zalotores/sistemaDeRiego/README.md

# sistemaDeRiego
# Proyecto mecatronico - UTN 
https://youtu.be/Zvare01FY24
