zalotores/sistemaDeRiego/informeProyectoTorres.pdf

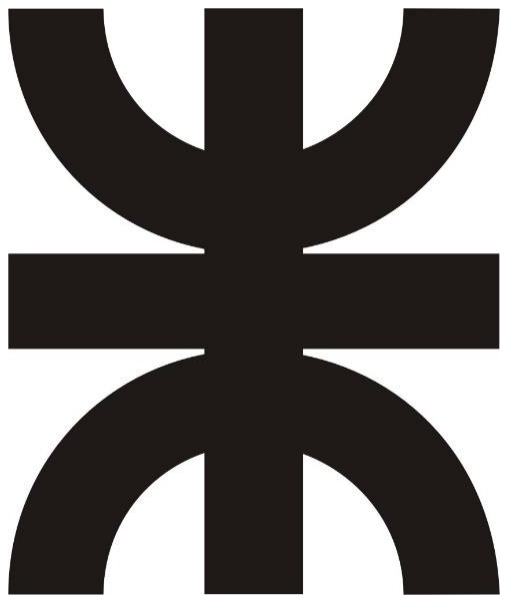
[picture p1: figure]

# UTN – FRC

# MECATRONICA 2

# PROYECTO MECATRONICO

# INFORME DE PROGRESO

## Torres, Horacio Gonzalo

108832

2020 - 2022 | Tecnicatura Superior en Mecatrónica
Docentes | Claudio Alejandro Zabala – Guillermo Stettler | Materia: | Mecatrónica II
Alumno: | Horacio Gonzalo Torres | Legajo: | 108832 | Curso: | 2M2

### INTRODUCCION

El presente informe tiene como objetivo ilustrar el proceso de desarrollo del sistema de riego automático que será presentado como proyecto final de esta tecnicatura; también incluye el manual de uso para el usuario final. Este proyecto tuvo inicio en el año 2020 con la intención de terminarlo dentro del ciclo lectivo de ese año; por variadas circunstancias se dejó de lado en la etapa de fabricación, completándose en diciembre de 2022.

2020 - 2022 | Tecnicatura Superior en Mecatrónica
Docentes | Claudio Alejandro Zabala – Guillermo Stettler | Materia: | Mecatrónica II
Alumno: | Horacio Gonzalo Torres | Legajo: | 108832 | Curso: | 2M2

### INDICE

Introducción | 1
Índice | 2

Anteproyecto
Elaboración | 3
Gantt | 3
Aprobación | 5

Investigación
Sensor de Humedad | 6
Reloj | 7
Actuadores | 8
Controlador | 8
Display i2c | 9
Reloj | 10
Reloj | 10
Botánica | 11

Programación
Lógica de Funcionamiento | 12
Desarrollo | 12
Código | 13
Materiales y Costos | 17
Construcción | 19
Conclusión | 25
Apéndice 1 – Manual de Usuario | 26

2020 - 2022 | Tecnicatura Superior en Mecatrónica
Docentes | Claudio Alejandro Zabala – Guillermo Stettler | Materia: | Mecatrónica II
Alumno: | Horacio Gonzalo Torres | Legajo: | 108832 | Curso: | 2M2

### ANTEPROYECTO

Elaboración:
Se pretende automatizar el riego de una quinta doméstica. Se utilizará un controlador con sensores de humedad y un reloj como entrada, y válvulas de caudal de agua como salida.
Se realizará con la idea de poder ampliar a un sistema de riego de frutales a futuro (como proyecto productivo); al utilizarlo en una quinta permite la construcción a escala real además de una maqueta, quedando la construcción en el sitio subordinada a otras obras de infraestructura.
La idea surgió originalmente como un proyecto de riego para una plantación de nogales en la provincia de San Luis. Los nogales necesitan una provisión de agua constante para lograr un crecimiento rápido y, de esta forma, poder entrar en producción. La plantación en cuestión pertenece a un tercero (amiga de la familia), por lo que la idea era, al tratarse de un proyecto de tecnicatura, que el propietario solo pague los materiales necesarios; el costo de mano de obra lo toma el alumno a cambio de la posibilidad de experimentar en el sitio, y la experiencia obtenida.
La actual pandemia limito severamente la posibilidad de viajar y planificar acciones a distancia en el mediano y corto plazo. Esta misma pandemia también propicio la creación de una quinta doméstica en nuestro hogar, por lo que una solución para poder realizar el proyecto en los plazos estipulados por la catedra, y al mismo tiempo beneficiar la economía y alimentación familiar se presentó en la forma de un cambio de objetivos, manteniendo el núcleo del proyecto con mínimas modificaciones.
Otra de las razones que impulsan este proyecto es la construcción de una nueva casa en la zona de Anisacate; en este terreno ya estaba planificada una quinta, y un sistema de riego automático sería un agregado de valor al proyecto familiar.
Como objetivo general, se busca lograr un sistema de riego autónomo y eficiente. Como objetivos individuales pueden mencionarse familiarizarse con sensores, clock y actuadores, aprender y manejar lenguajes de programación para controladores, manejar conexiones AC/DC, fabricación de una fuente CC, mejorar la manufactura de plaquetas y técnicas de soldadura, cálculo de resistencia estructural, investigar ciclos de crecimiento y humedad necesarias para diversos tipos de plantas.
El proyecto fue escogido, entre otros factores, por la factibilidad y economía relativa para llevarlo a cabo. La idea es lograr terminar el mismo en los plazos estipulados y hacerlo con cierta flexibilidad, lo que permitirá la implementación en diversos grados de complejidad.
Si bien hay otros proyectos de mayor complejidad que pueden desarrollarse en tiempos similares, este sistema tiene integración con varias de las materias de la tecnicatura (mecánica, electrónica, mecatrónica, materiales, física, calidad) por lo que considero que es adecuado como proyecto mecatrónico.
Este tema aborda un problema de índole domiciliario, y también se puede llevar a una escala mayor, por lo que se podría extender a una solución industrial. Si bien no se hizo todavía un análisis de costos, en general se considera factible ya que todos los componentes son de costo bajo/ moderado, y los conocimientos para realizar el proyecto se adquirieron en la carrera, salvando cuestiones particulares que se deberán investigar para aplicar eficientemente el mismo.

Diagrama de Gantt:

Se incluye, a modo ilustrativo, el diagrama original para el anteproyecto. El mismo se ira modificando a medida que avance el proyecto para mantenerse acorde al progreso actual, tratando dentro de lo posible de mantener las fechas de entrega dentro de lo programado con el objetivo de completar el proyecto en este mismo año. Cabe destacar que se producirán retrasos tanto por logística de materiales como por la formación académica necesaria para concretar las diferentes etapas del proyecto, ya que la fecha indicada en el diagrama no tiene en cuenta la curva de aprendizaje y nivel técnico necesario para construir las diferentes partes.

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

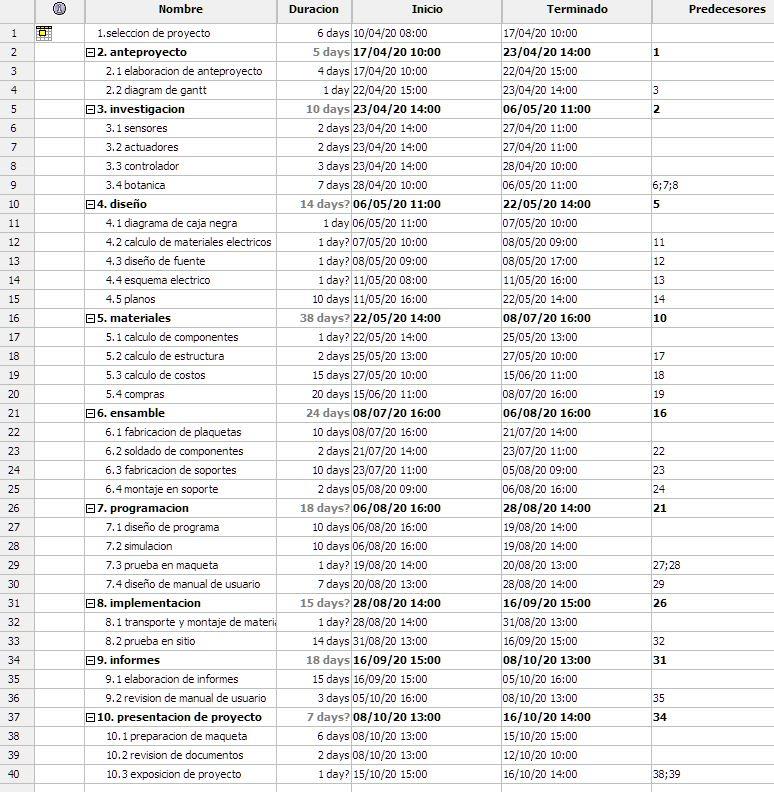
[picture p2: figure]

Figura 1

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

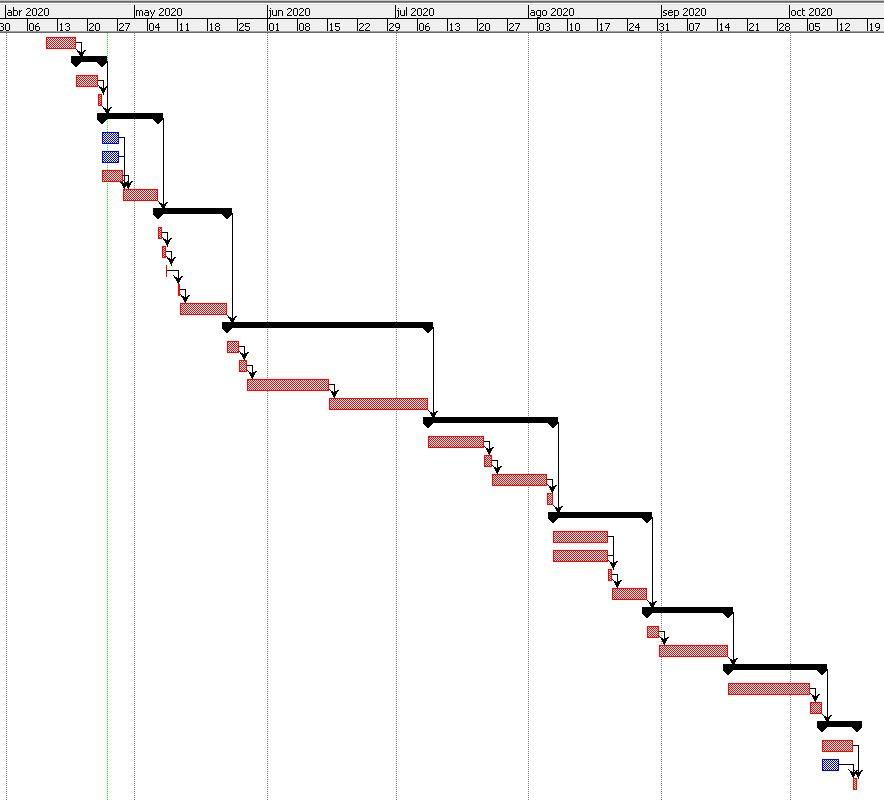
[picture p3: figure]

Figura 2

Aprobación:

El presente proyecto fue enviado para aprobación el día 23 de Abril del año 2020, y aprobado para su construcción el día 28 de Abril del mismo año.

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

### INVESTIGACION

Sensor de Humedad:

El sistema de riego funciona en base a sensores y actuadores, los cuales se tomarán como dispositivos de entrada y salida, respectivamente; un controlador tomara los datos de entrada y actuara, basando en instrucciones preestablecidas, sobre los actuadores para generar las condiciones de humedad requeridas según el tipo de cultivo que se tenga en consideración.
Para la realización del proyecto se utilizarán dos tipos de sensores o dispositivos de entrada. Estos serán un sensor de humedad y un reloj que, si bien no es un sensor, es un elemento necesario para medir escalas de tiempo prolongadas (del orden de días).

El sensor de humedad elegido es el FC-28, el mismo tiene un costo relativamente bajo y una vida útil de varios años.

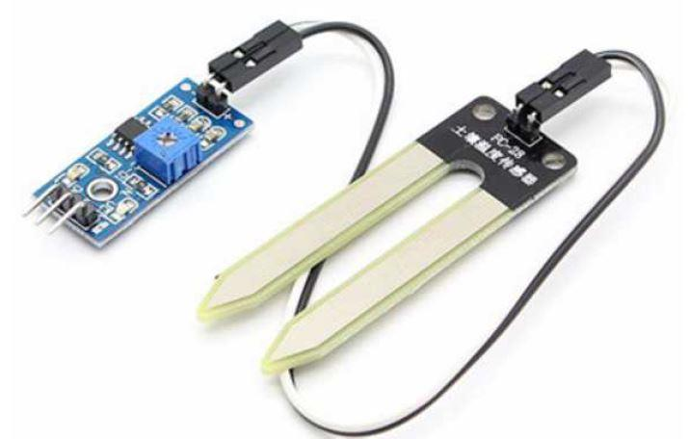
[picture p4: figure]

Figura 3

Un higrómetro de suelo FC-28 es un sensor que mide la humedad del suelo. Son ampliamente empleados en sistemas automáticos de riego para detectar cuando es necesario activar el sistema de bombeo. El FC-28 es un sensor sencillo que mide la humedad del suelo por la variación de su conductividad. No tiene la precisión suficiente para realizar una medición absoluta de la humedad del suelo, pero tampoco es necesario para controlar un sistema de riego. El FC-28 se distribuye con una placa de medición estándar que permite obtener la medición como valor analógico o como una salida digital, activada cuando la humedad supera un cierto umbral. Los valores obtenidos van desde 0 sumergido en agua, a 1023 en el aire (o en un suelo muy seco). Un suelo ligeramente húmero daría valores típicos de 600-700, mientras que un suelo seco tendrá valores de 800-1023.
Se pretende usar esta variación analógica para adaptar el sistema a diferentes condiciones de humedad, las que son necesarias teniendo en cuenta la variedad de vegetales que se encuentran en un quinta. De esta forma, se pueden separar los distintos tipos de suelo utilizando un sensor por zona, y ajustando el valor que el controlador tomara como umbral para activar el riego.
El esquema de montaje se muestra en la fig. 4. Al tratarse de una entrada analógica, solo pueden usarse los pines analógicos del micro; en caso de necesitar un número elevado de sensores, se pueden usar en modo digital, configurando un valor umbral para cada sensor, el cual enviara una señal digital al micro para indicar la activación o cierre de riego. También se utiliza como sensor de nivel en modo digital para asegurar el suministro de agua de riego.

2020 - 2022 | Tecnicatura Superior en Mecatrónica

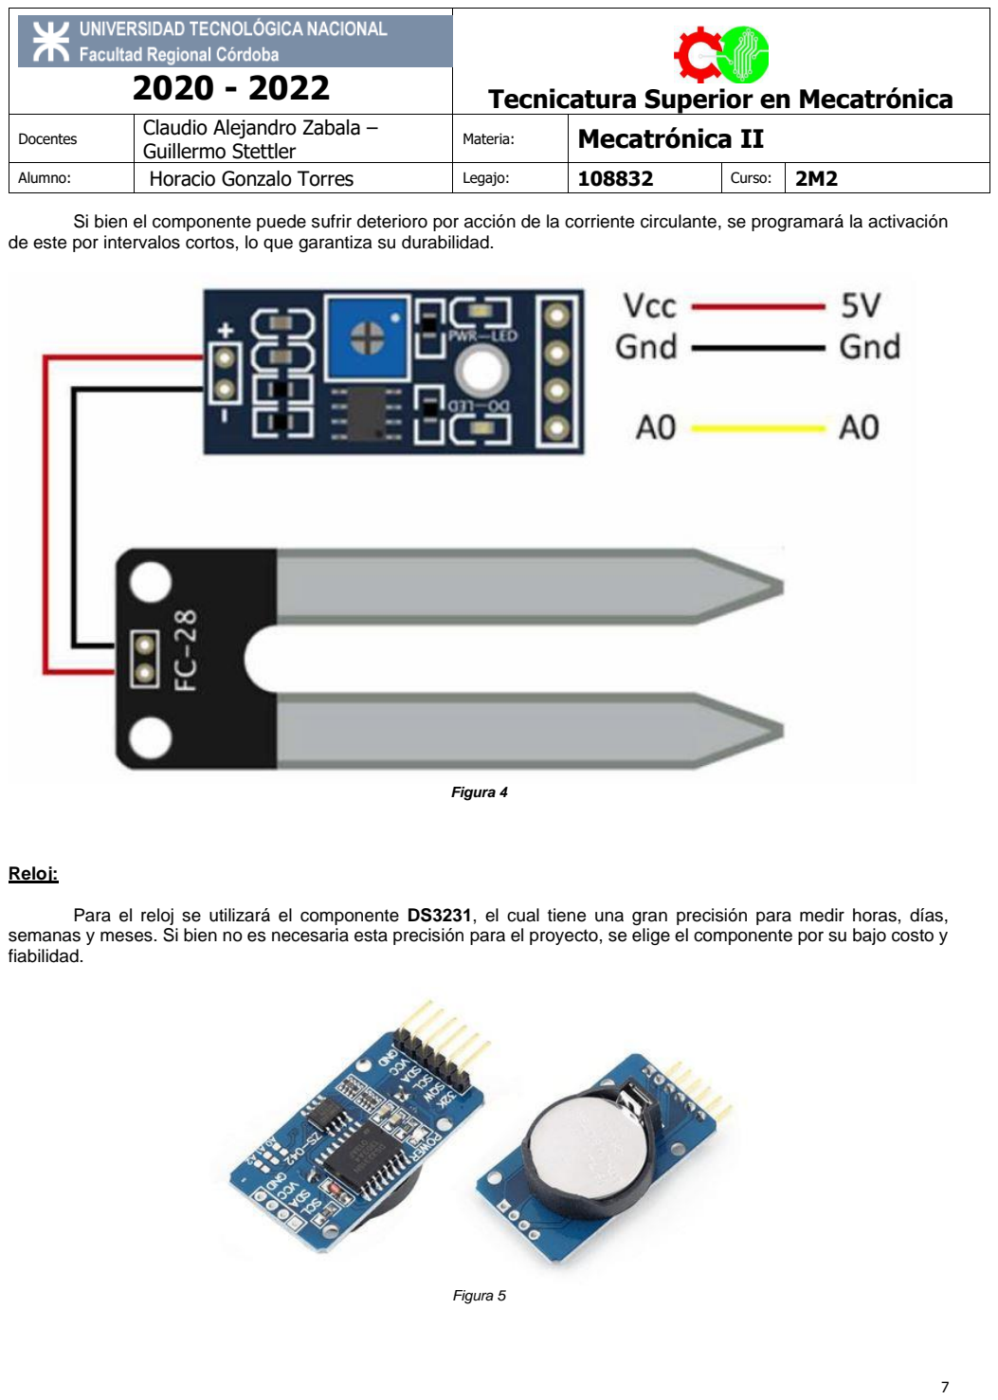
[picture p5: page 8]
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

Si bien el componente puede sufrir deterioro por acción de la corriente circulante, se programará la activación de este por intervalos cortos, lo que garantiza su durabilidad.

Figura 4

Reloj:

Para el reloj se utilizará el componente DS3231, el cual tiene una gran precisión para medir horas, días, semanas y meses. Si bien no es necesaria esta precisión para el proyecto, se elige el componente por su bajo costo y fiabilidad.

Figura 5

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

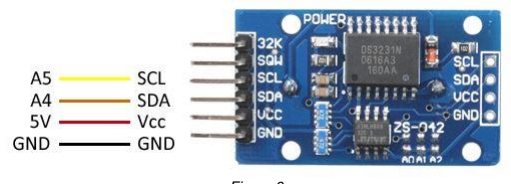
[picture p6: figure]

Figura 6

La medición de tiempo es necesaria, ya que hay plantas que requieren desde un riego diario a un riego semanal; también cambian los requerimientos de riego en la época de cosecha. Este componente también cuenta con un sensor de temperatura, el que puede ser útil para llevar un registro de la temperatura ambiente. Al contar con una fuente de alimentación propia, se puede usar como controlador de encendido de todo el sistema, reduciendo el consumo eléctrico y reduciendo el impacto de posibles cortes de energía desde la red.

Actuadores:

Para controlar el flujo de agua, se utilizan bombas de agua sumergibles para pecera, las cuales funcionan con una alimentación de 5V, tienen un costo bajo y una vida útil aceptable.

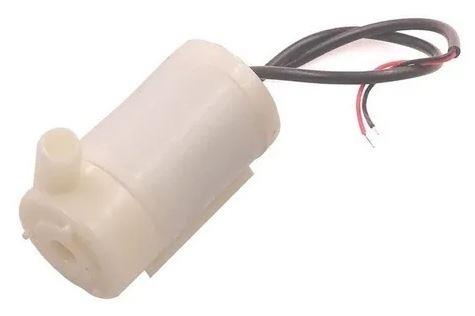
[picture p7: figure]

Figura 7

La conexión es muy sencilla, pudiéndose controlar con señales digitales. Dependiendo del tipo de aspersor se puede utilizar tanto para riego de superficie (como es el caso del tomate) como para riego tipo lluvia (como es el caso de la lechuga). Si bien también se podrían utilizar para llenar el depósito de agua, es preferible en este proyecto un sistema de llenado mecánico por flotante, al tener disponibilidad de agua corriente; para zonas donde no haya disponibilidad es recomendable una bomba de mayor caudal, el que se logra aumentando la potencia (y consecuentemente el costo) de la misma.

Controlador:

El controlador por utilizar es el ATmega328P, el cual se programa en una placa Arduino Uno, y posteriormente se monta en una placa de desarrollo propia. El mismo se alimenta de una fuente regulada a 5 Vcc, la cual también alimenta a las bombas de riego.

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

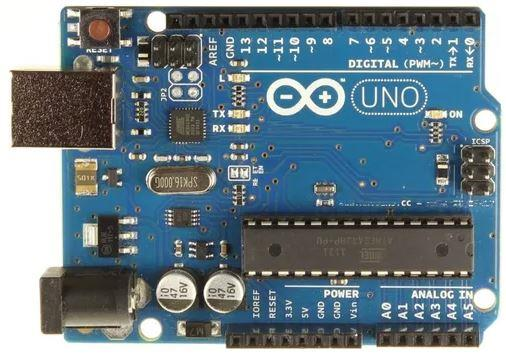
[picture p8: figure]

Figura 8

Este controlador dispone de seis entradas analógicas y trece digitales. El reloj utiliza dos entradas analógicas, por lo que admite hasta cuatro sensores (o zonas) de humedad en medición directa, pudiéndose agregar otros cuatro sensores adicionales en medición digital. Para aumentar la cantidad de señores (o zonas) sería necesario agregar un segundo micro, pero esto no es necesario para el caso de una quinta doméstica. También se pueden agregar interruptores para activar el modo de riego alternativo en situación de cosecha, los cuales se computan como entradas digitales.

Display i²c:

Para mostrar la información de salida se utiliza un display i2c, lo que permite simplificar el cableado no solo de la pantalla, sino también de los demás componentes que se conecten al microcontrolador. El protocolo de comunicación es ideal para este proyecto, ya que las distancias de conexión son pequeñas, y el menor cableado permite un producto final más compacto. El display en cuestión es de 16 caracteres con dos líneas de salida.

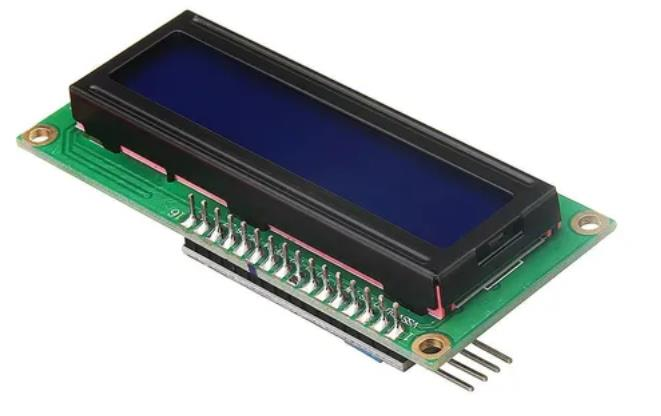
[picture p9: figure]

Figura 9

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

Potenciómetros:

Para regular los niveles de humedad se utilizan potenciómetros lineales de 10k conectados a las entradas analógicas del controlador, esto garantiza un movimiento lineal y continuo entre los valores de entrada.

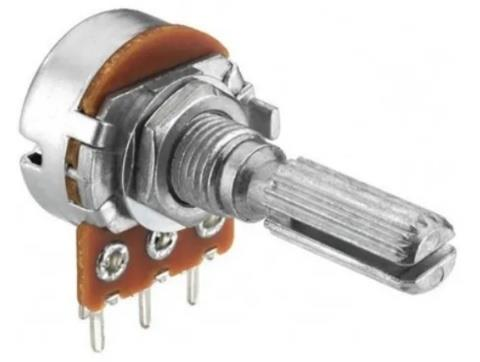
[picture p10: figure]

Figura 10

Salida de Potencia:

Para la salida de los actuadores se utiliza un puente H en una placa L298N, de esta forma se evita drenar demasiada potencia del controlador, lo que puede resultar en un daño de este.

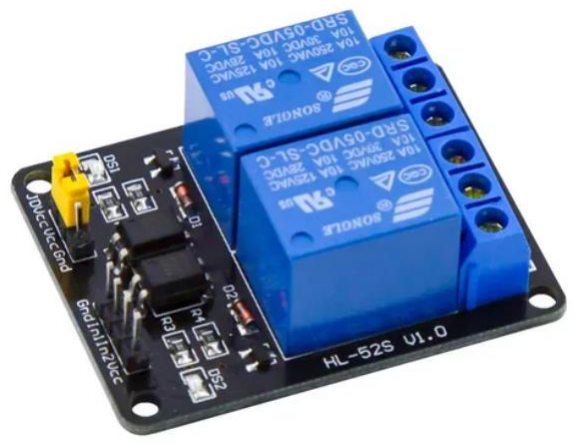
[picture p11: figure]

Figura 11

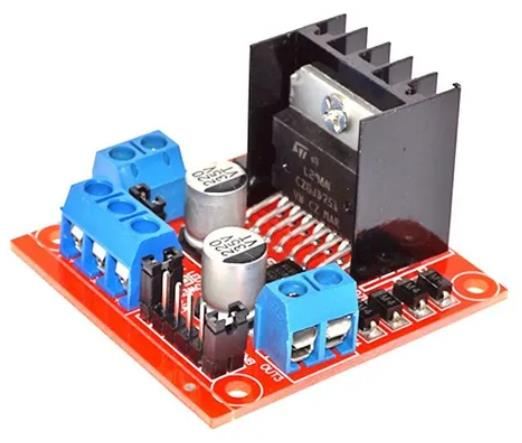
[picture p12: figure]

En caso de que se necesite escalar el proyecto, se puede reemplazar el puente por una placa de Relays, lo que permite cambiar las bombas de 5V por bombas de 220V, o también por válvulas de 220V dependiendo de la fuente de agua disponible.

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

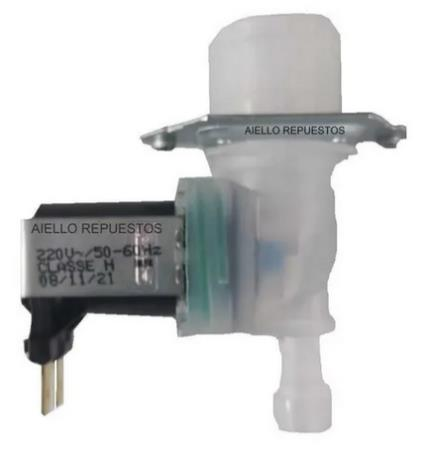
[picture p13: figure]

Figura 12

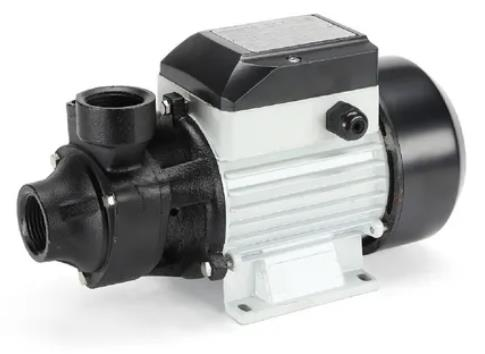
[picture p14: figure]

Botánica:

Se pueden tomar dos grandes categorías, las plantas que requieren riego por aspersión (lluvia) y las plantas que requieren riego por goteo. También se dividen según el nivel de humedad requerida, teniendo en casi todos los casos una condición de humedad para crecimiento y otra para la etapa de floración y cosecha.
A los fines de este proyecto se tomarán verduras de hoja (lechuga) para riego por aspersión y las demás plantas para riego por goteo (ej tomate). La diferencia entre estos métodos consiste en que las plantas de hoja necesitan humedad en sus hojas; mientras que este tipo de riego es perjudicial para otras plantas y árboles, debido a que esta humedad en la hoja promueve el crecimiento de hogos y plagas que son más fáciles de controlar cuando la planta esta seca, pero la tierra esta húmeda.

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

PROGRAMACION

Lógica de Funcionamiento:

El funcionamiento se basa en dos características principales: mantener un nivel de humedad mínimo y efectuar el riego en horarios en los cuales este no afecte negativamente a la planta.
Para los niveles de humedad se usan los sensores FC-28, los que envían una señal analógica que se convierte a través del ADC del microcontrolador en un valor entre 0 y 1023. Este valor es comparado con el umbral seteado por el usuario, que se obtiene de un potenciómetro lineal que genera también un valor entre 0 y 1023 mediante el ADC del micro.
Para el horario de riego se usa el reloj DS3231, habilitando una ventana de riego por la mañana y otra por la tarde. También se aprovecha el reloj para mostrar la fecha y hora en pantalla y la temperatura interna del gabinete. Las ventanas se configuraron entre las 8 y las 10 de la mañana, y entre las 7 y las 10 de la tarde.
Dadas las condiciones de horario de riego dentro de la ventana, y de humedad censada inferior al umbral seteado, el micro habilita la salida a los actuadores, representados por las bombas de 5V alimentadas por el puente L298N; estos actuadores se activan por un intervalo de 10 segundos durante el cual se libera el caudal de agua en la maceta. Se programa también 3 segundos de espera en la fecha, y 3 segundos en la pantalla de porcentajes de humedad medidos y seteados, lo que da un ciclo con una duración de entre 6 segundos (sin riego) y 26 segundos (con ambas bombas funcionando). Con el caudal de las bombas se estima que la maceta alcance el mínimo de humedad en un tiempo de entre 3 y 4 ciclos (dependiendo del caudal y la ubicación relativa entre la salida de agua y el sensor).

Desarrollo:

Para el programa se utilizaron dos bibliotecas: RTClib.h y LiquidCrystal_I2C.h, teniendo esta última incluida la biblioteca Wire.h con el protocolo de comunicación i2c.

https://github.com/adafruit/RTClib

https://github.com/Konredus/LiquidCrystal_I2C

En la primera parte del código se declaran los objetos reloj y lcd, y las variables que se van a usar para imprimir y manejar los datos. En setup se declaran las salidas y se inicializan variables. también se setea la fecha del reloj a la fecha de compilación, manteniéndose la hora en caso de pérdida de energía por medio de una batería conectada al reloj.
En el loop se inicia leyendo los valores censados de humedad, recortando el máximo y el mínimo para evitar variaciones de final de carrera, logrando una variación leída entre 5% y 100%. Estos valores se guardan como variables int para facilitar su manejo.
Luego se declaran las variables de fecha y hora con el formato deseado, y se cargan los valores leídos del reloj. También se capturan el día (en formato 0 a 6), la hora (en formato int 0 a 23) y la temperatura interna (también en int).
Luego se limpia la pantalla, posiciona el cursor en 0 de la fila superior (0,0) e imprime el día extraído del String de semana correspondiente al día leído en el reloj. Se cambia el cursor a (8,0) y se imprime la fecha. Luego se cambia el cursor a la segunda fila (0,1) y se imprime la temperatura interna. Se cambia el cursor a (8,1) y se imprime la hora. Finalmente se setea un delay de 3 segundos para facilitar la lectura.
Luego de este tiempo se limpia la pantalla, y se imprimen los valores de los sensores 1 y 2 en la primera fila, y los valores de los umbrales 1 y 2 en la segunda fila. Se carga un delay de 3 segundos para poder visualizar los valores.
Finalmente, si se cumplen las condiciones de hora y valores de humedad, se cambia el estado de las salidas a las bombas, de a una a la vez, por un transcurso de 10 segundos. Se imprime la leyenda “REGANDO” y “Bomba 1” o “Bomba 2” según corresponda.
El ciclo termina, e inicia un nuevo loop.

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

Código:

El código final es el que se muestra:

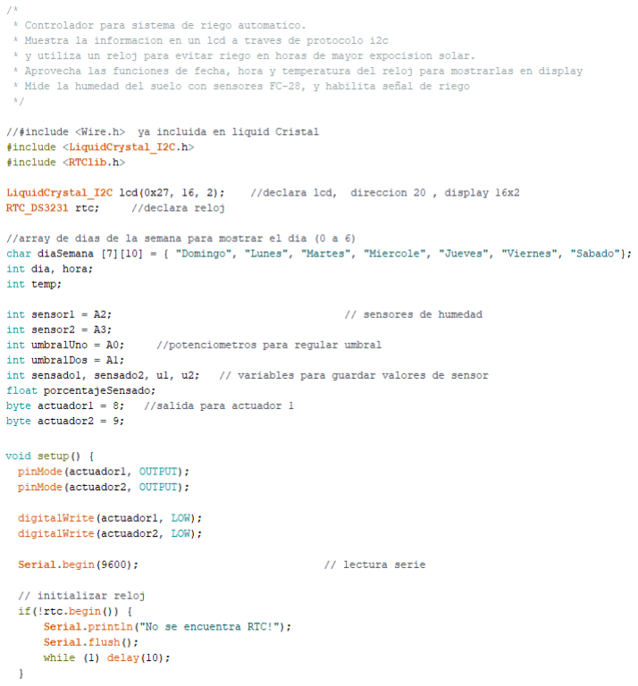
[picture p15: figure]

2020 - 2022 | Tecnicatura Superior en Mecatrónica

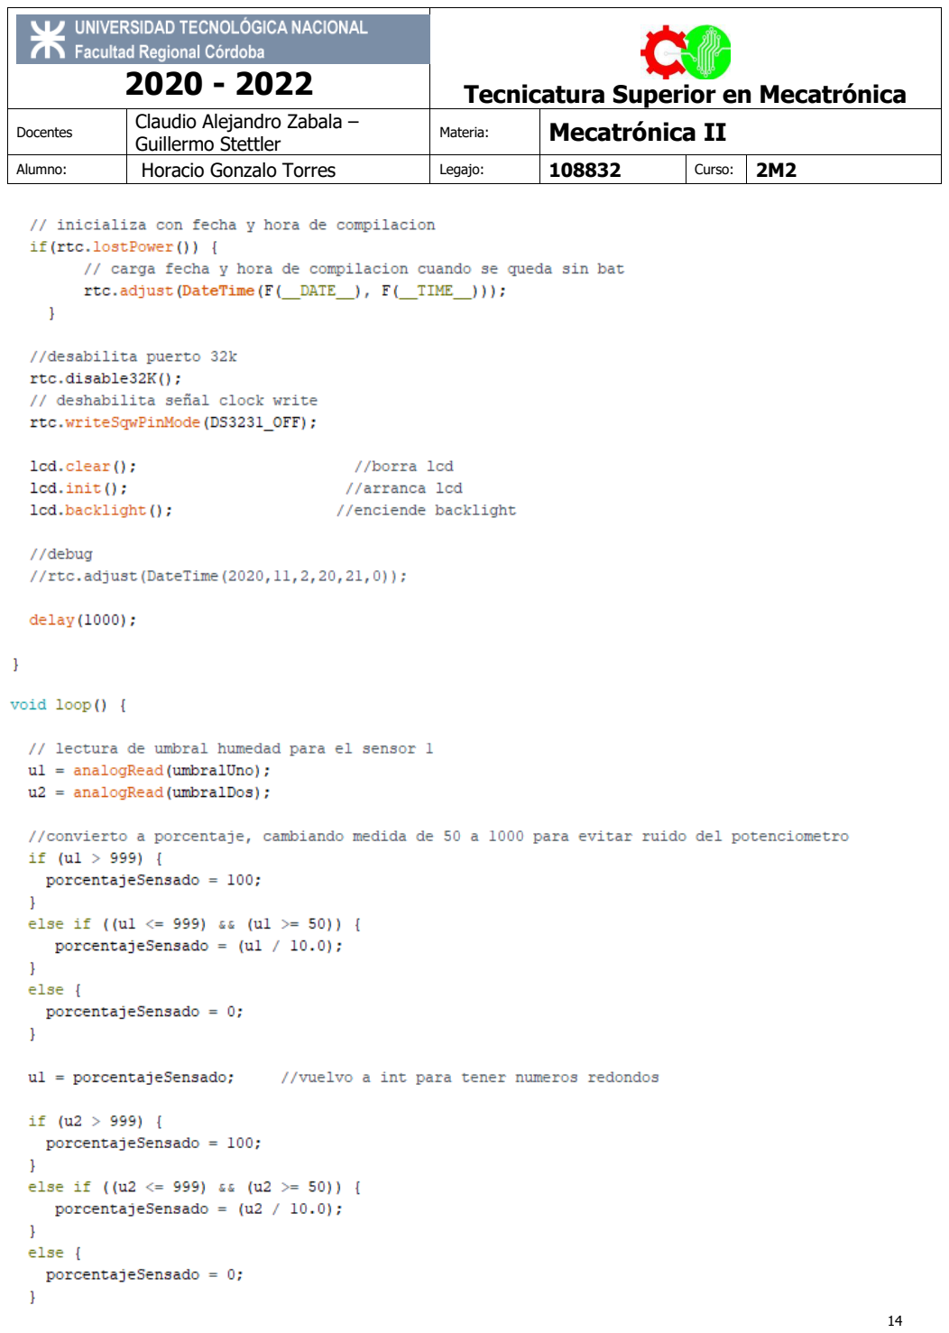
[picture p16: page 15]
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

2020 - 2022 | Tecnicatura Superior en Mecatrónica

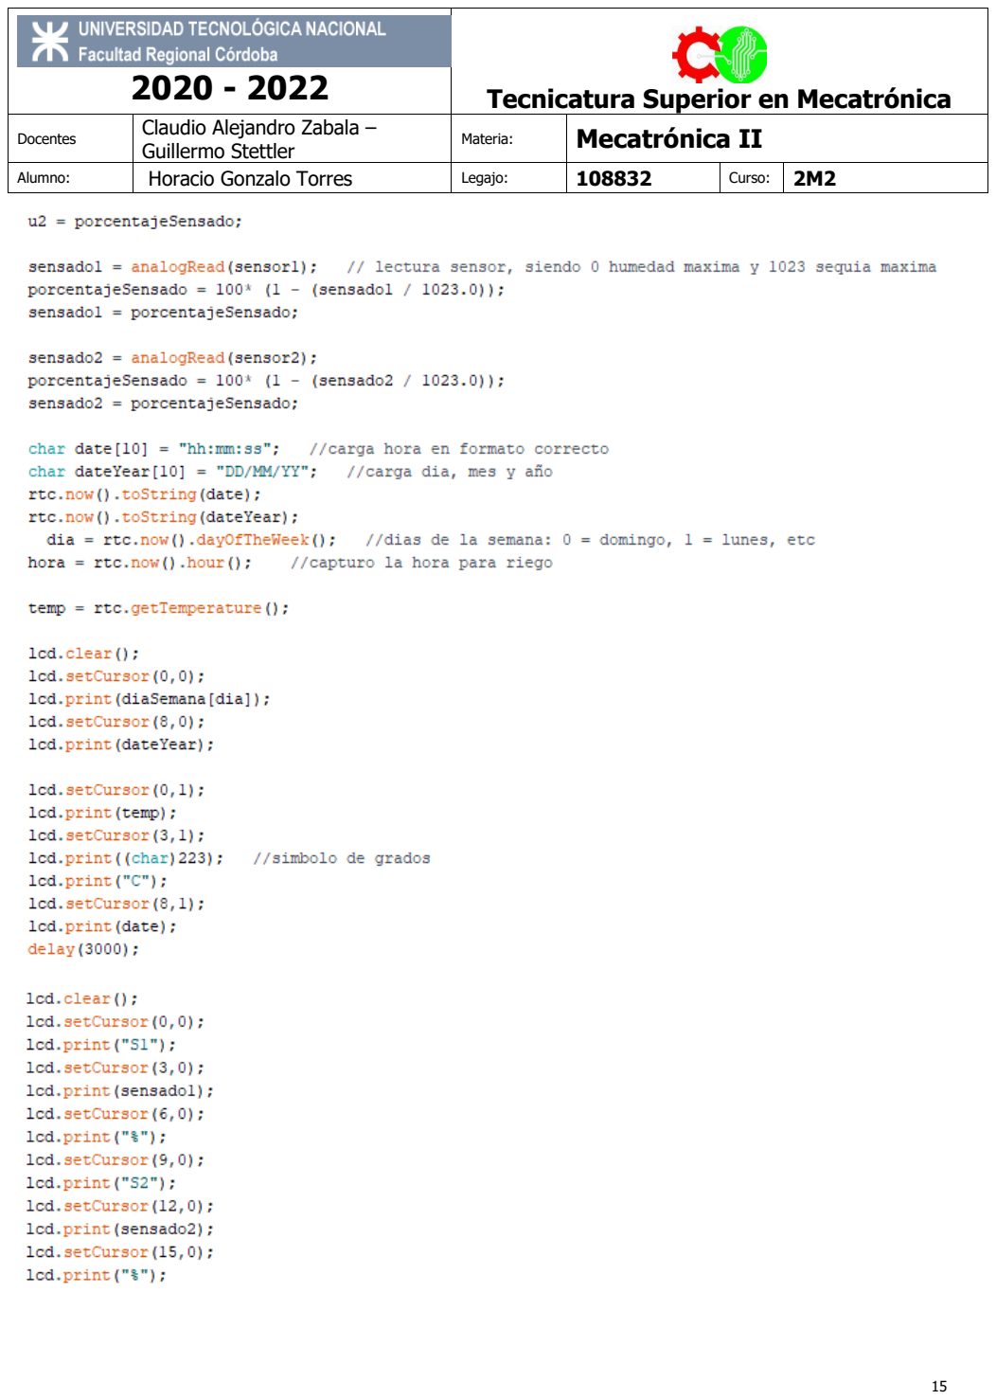
[picture p17: page 16]
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

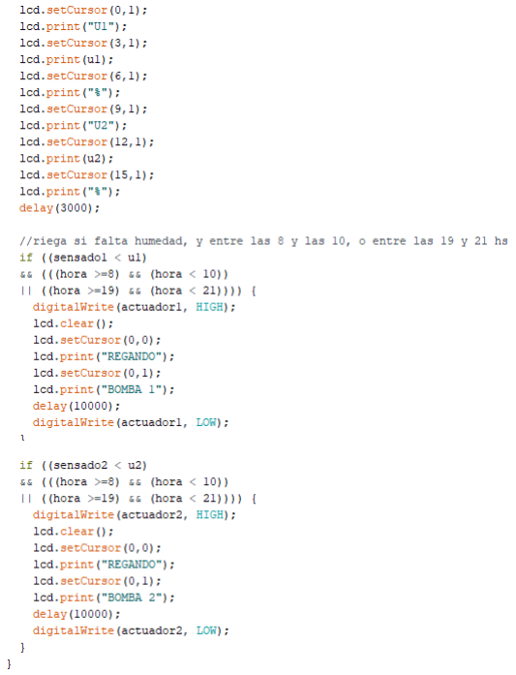
[picture p18: figure]
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

MATERIALES Y COSTOS

Una vez completada la lógica, se procede al presupuestado y adquisición de los componentes necesarios. Algunos de estos componentes fueron extraídos de proyectos anteriores, otros ya habían sido adquiridos sin haber sido usados, y otros fueron reciclados; por esta razón el presupuesto real fue mucho menor al calculado. Los costos se expresan en moneda dólar libre (blue) para mantener una referencia que se mantenga en el tiempo. Los costos unitarios quedan, entonces, según se detalla en la siguiente tabla:

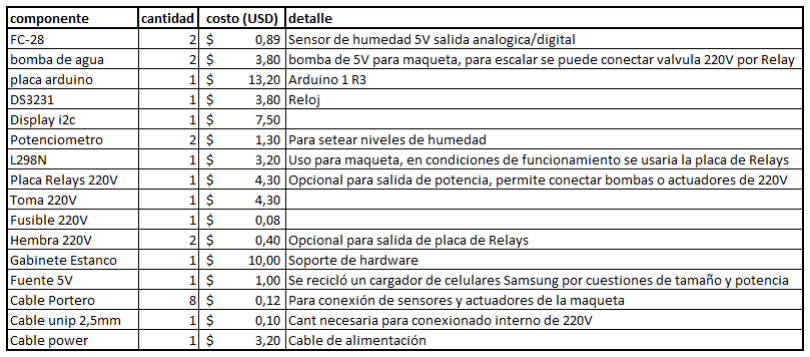
[picture p19: figure]

Sumando los costos unitarios por la cantidad de componentes, se calcula un total de USD 64,42 por unidad, sin contar insumos como estaño y alcohol isopropílico, cables de conexionado interno, mano de obra y electricidad. En el mercado, se puede adquirir un controlador de similares características a partir de los USD 85, a lo que habría que agregar sensores y actuadores. https://articulo.mercadolibre.com.ar/MLA-614522414-programador-riego-hunter-automatico-x-core-2-estaciones-_JM

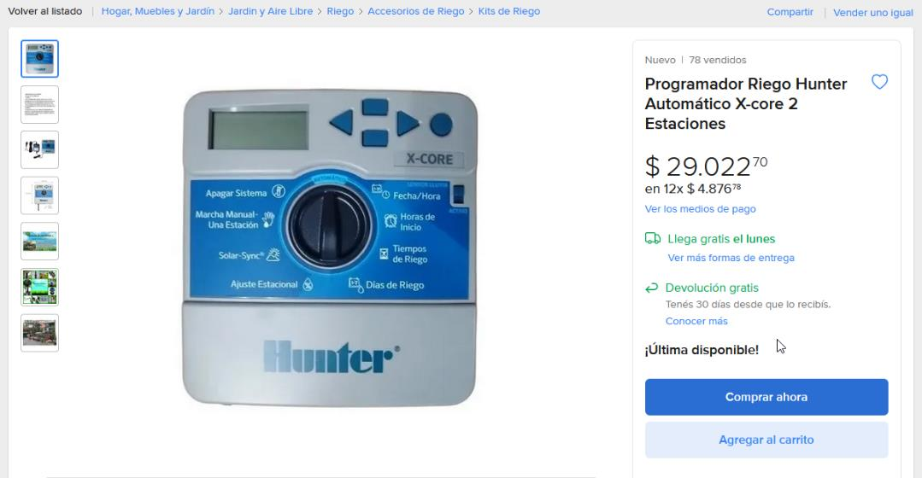
[picture p20: figure]

Figura 13

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

Considerando costos y precios de mercado, se podría lograr un precio de venta competitivo alrededor de los USD 100, lográndose un margen superior al 30%. Este valor es estimativo, teniendo en cuenta que en caso de entrar en producción se podrían reducir costos al comprar al por mayor, y cambiando el microcontrolador con una placa diseñada solamente para ser usada en el control de riego. Tampoco se tienen en consideración costos impositivos, administrativos y comerciales (marketing y despacho).

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

CONSTRUCCIÓN

Una vez completada la lógica, se procede al presupuestado y adquisición de los componentes necesarios. Algunos de estos componentes se reutilizaron de otros proyectos, otros se habían comprado previamente sin llegar a usarse, y otros materiales fueron reciclados. Por estas razones, el costo real del prototipo fue menor al calculado.

Primero se practicaron incisiones en una caja estanca, de forma de tener el espacio para adosar la toma de alimentación, el display, y poder conectar sensores y actuadores.

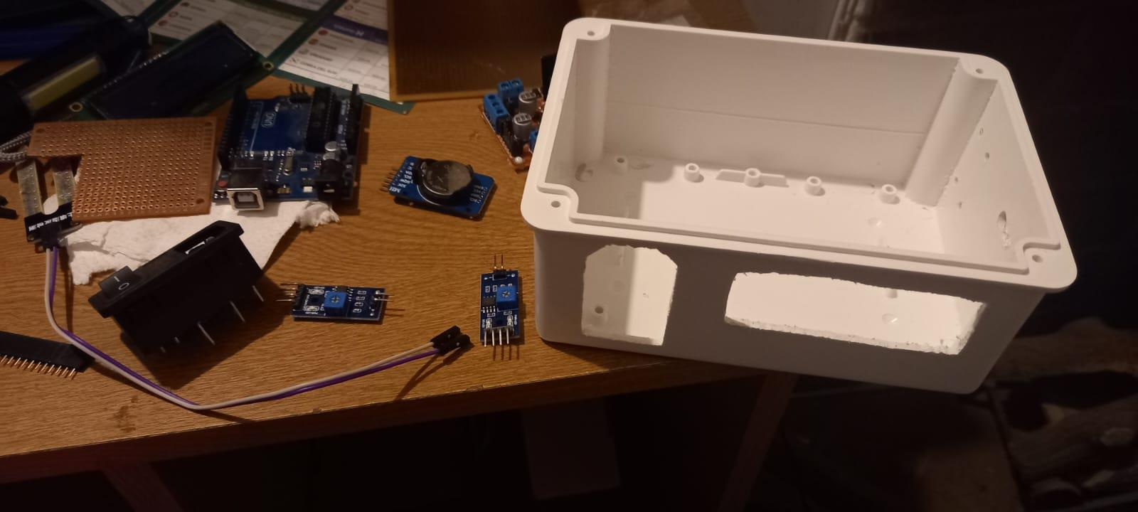
[picture p21: figure]

Figura 13

Luego se probaron los componentes individualmente, haciendo programas auxiliares con salida serial al monitor para configurar adecuadamente los sensores, actuadores, el display y familiarizarse con el protocolo i2c.

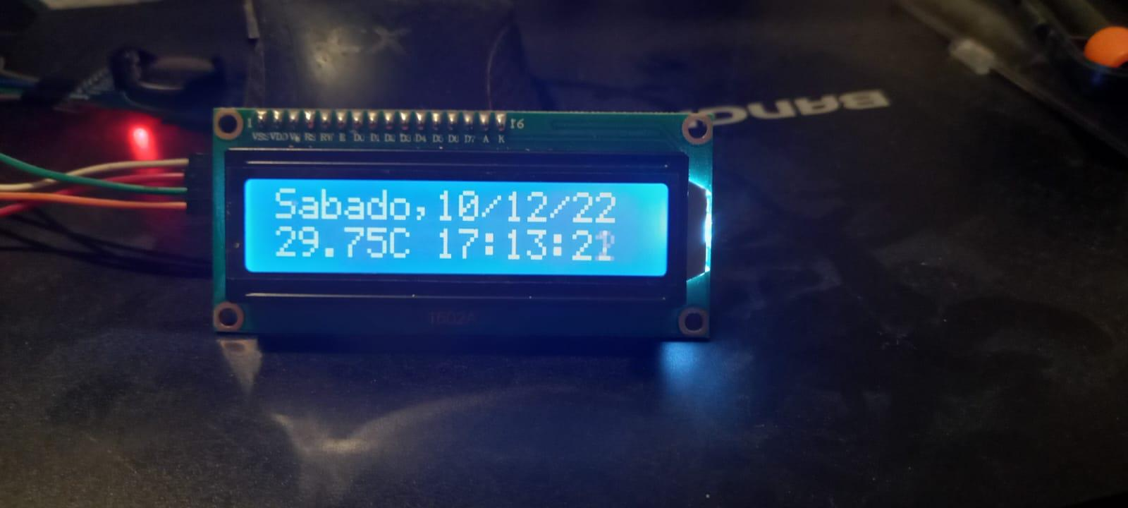
[picture p22: figure]

Figura 14

2020 - 2022 | Tecnicatura Superior en Mecatrónica

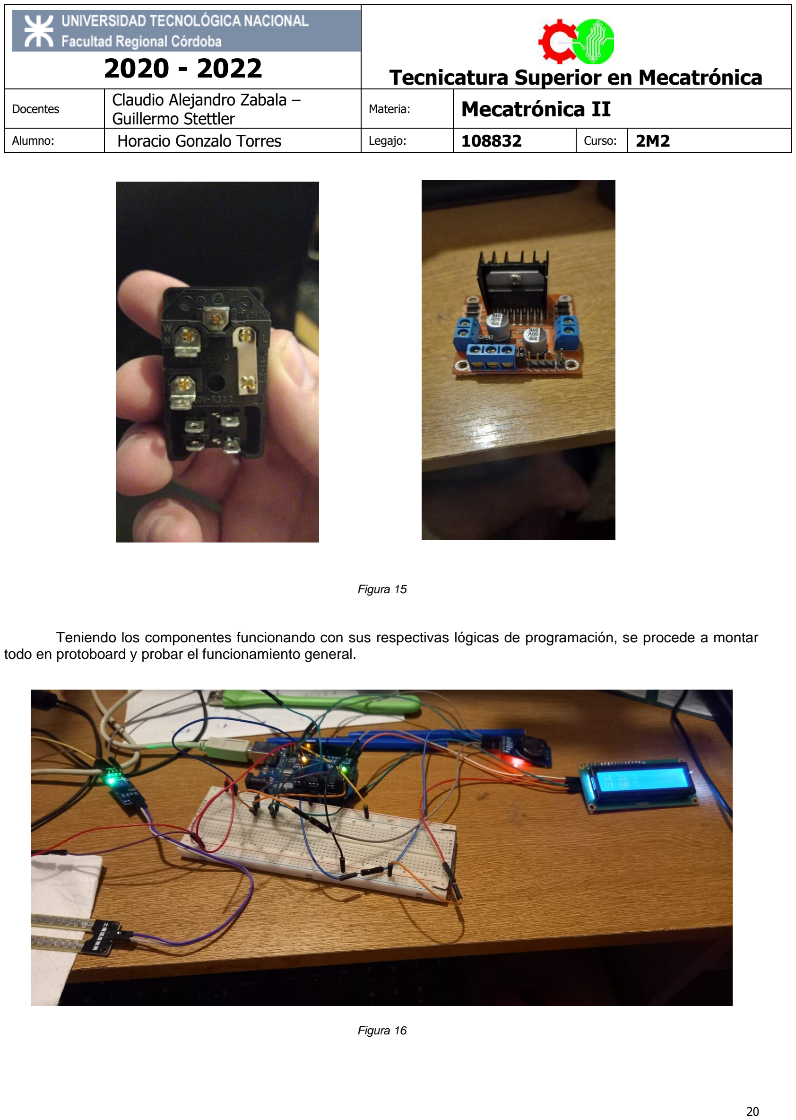
[picture p23: page 21]
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

Figura 15

Teniendo los componentes funcionando con sus respectivas lógicas de programación, se procede a montar todo en protoboard y probar el funcionamiento general.

Figura 16

2020 - 2022 | Tecnicatura Superior en Mecatrónica

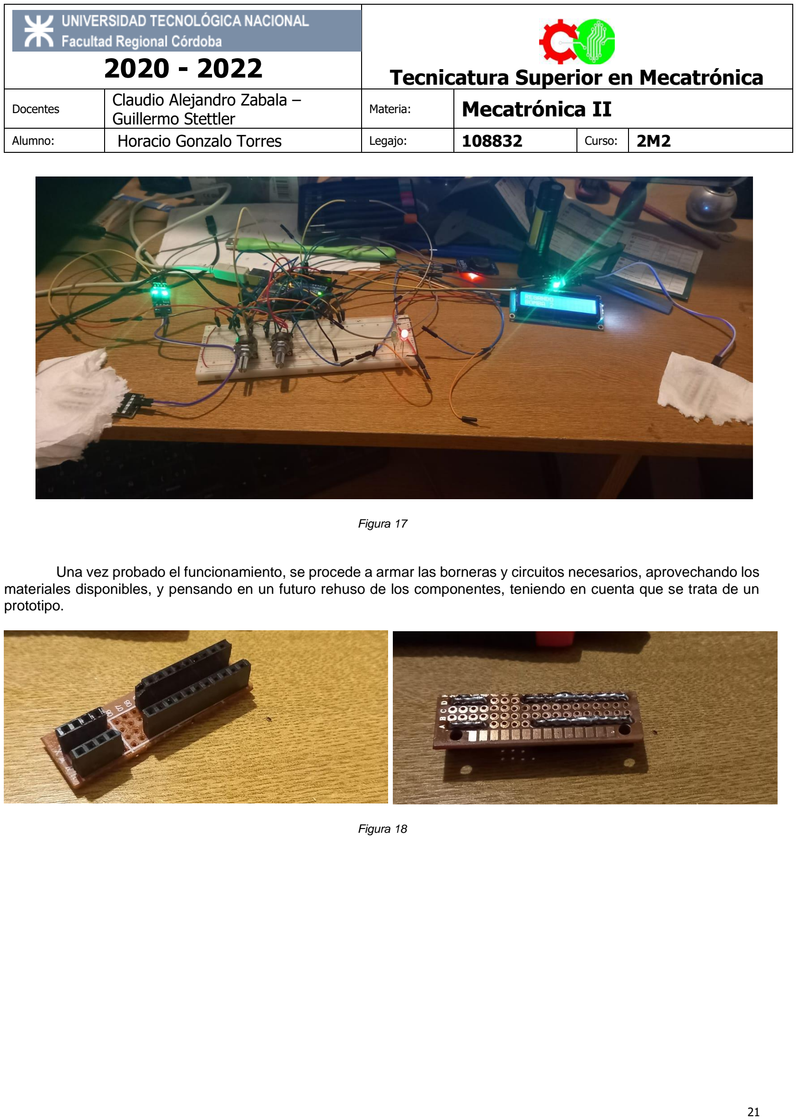
[picture p24: page 22]
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

Figura 17

Una vez probado el funcionamiento, se procede a armar las borneras y circuitos necesarios, aprovechando los materiales disponibles, y pensando en un futuro rehuso de los componentes, teniendo en cuenta que se trata de un prototipo.

Figura 18

2020 - 2022 | Tecnicatura Superior en Mecatrónica

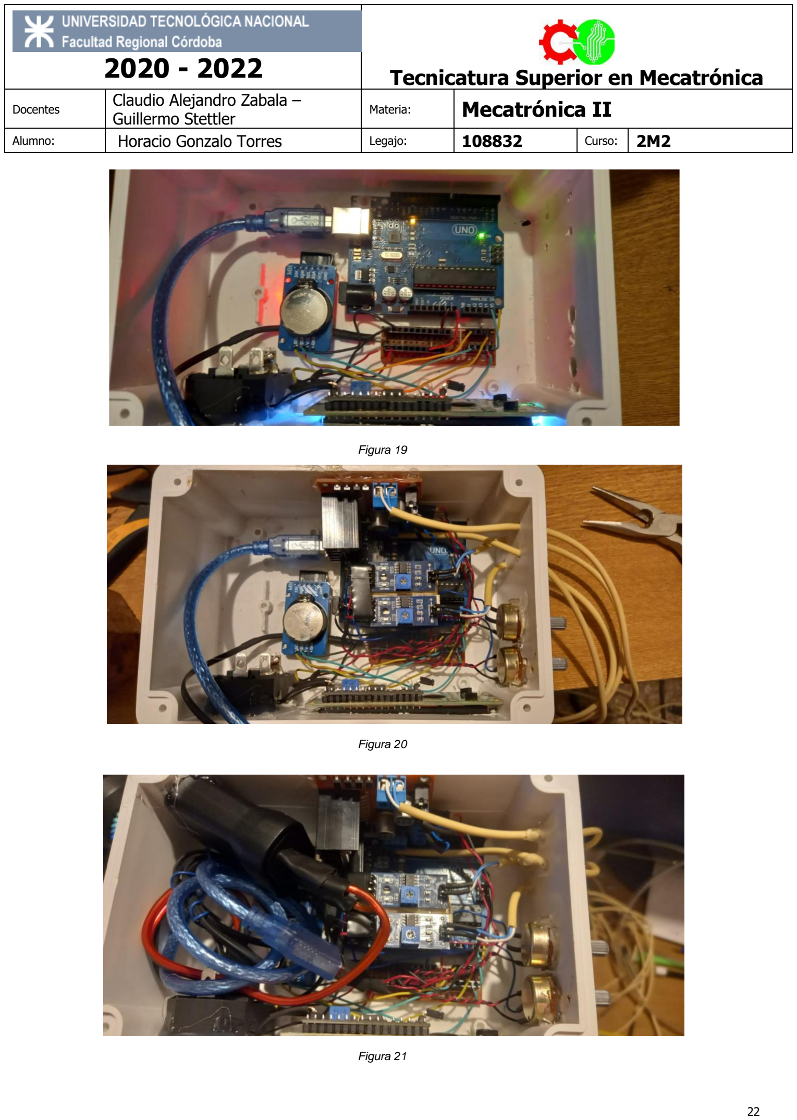
[picture p25: page 23]
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

Figura 19

Figura 20

Figura 21

2020 - 2022 | Tecnicatura Superior en Mecatrónica

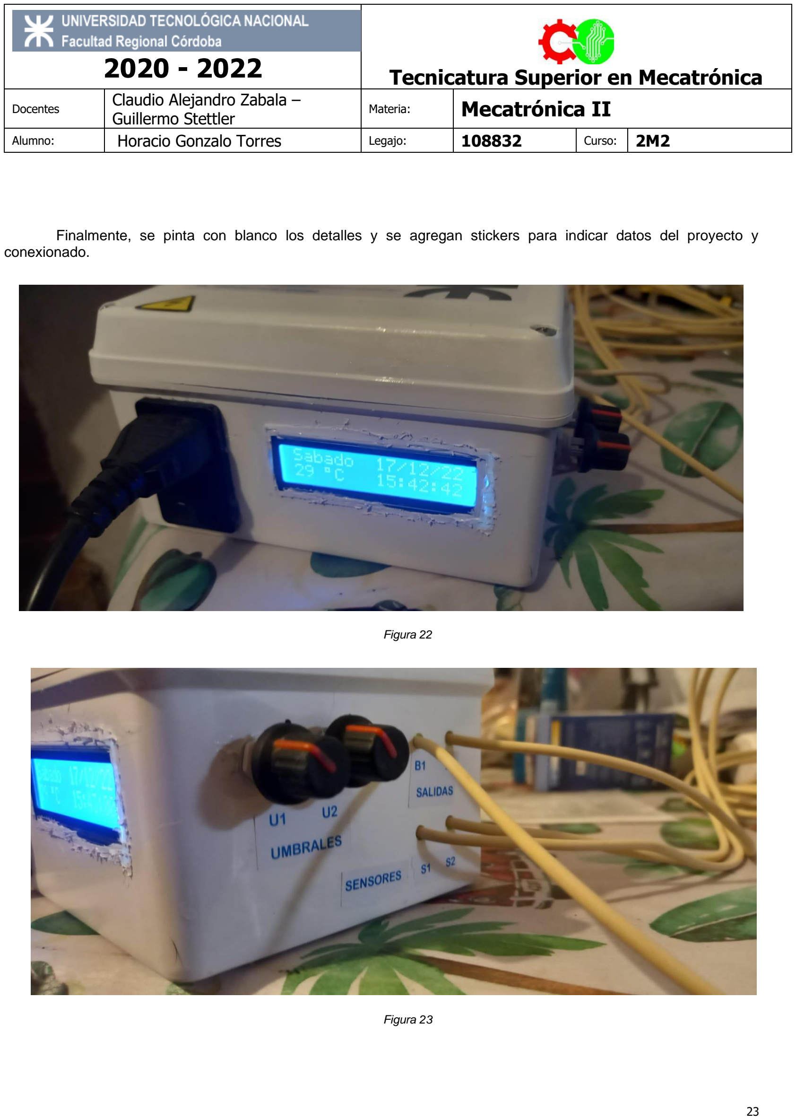
[picture p26: page 24]
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

Finalmente, se pinta con blanco los detalles y se agregan stickers para indicar datos del proyecto y conexionado.

Figura 22

Figura 23

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

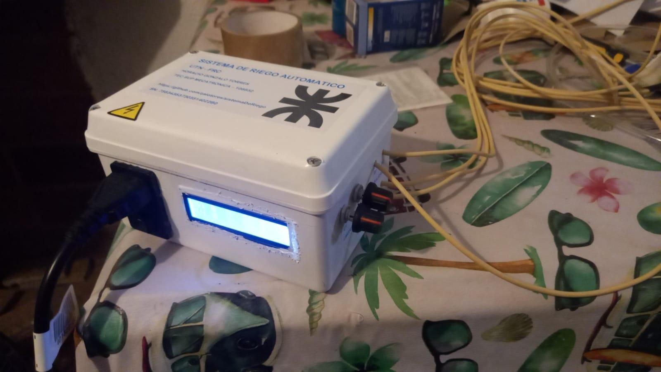
[picture p27: figure]

Figura 24

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

CONCLUSION

El proyecto sirvió para afianzar e integrar varias áreas de conocimiento impartidas durante el cursado de la tecnicatura. Si bien fue planteado con el objetivo de completarlo rápidamente, las particulares circunstancias del año 2020, sumadas a las crecientes responsabilidades de la vida adulta, hicieron que este proyecto perdure mucho más allá de la fecha planeada, mostrando la futilidad de planear un proyecto sin apegarse a las fechas estipuladas.
En lo referente a la parte técnica, el hecho de haber demorado tanto la construcción me forzó a repasar y practicar conceptos y técnicas que estaba ya dejando en desuso. Una vez tomado el ritmo, cada paso y cada avance se volvió en una pequeña victoria, haciendo el proyecto entretenido y estimulante. Se logró un funcionamiento estable con el prototipo funcionando exactamente como se había planeado. Si bien me preocupó posibles fallas por ruidos o señales inestables, el sistema en su conjunto demostró ser robusto, y el hecho de armar todo en un gabinete relativamente pequeño (si bien tuvo sus desafíos) resultó en un producto final más atractivo y portable, fácil de usar y de configurar.
En lo que respecta a implementación y producción, considero que este prototipo puede mejorarse, pero en su actual estado está en condiciones de funcionar perfectamente (lleva a la fecha más de tres semanas encendido y funcionando correctamente). Como se analizó en el informe, el proyecto puede generar una potencial ganancia, con un mercado relativamente grande para instalaciones domésticas, y más pequeño (pero más redituable) para aplicaciones agrícolas y rurales.

En conclusión, el prototipo funciona correctamente, es fácil de manejar y de conectar, y tiene un mantenimiento muy bajo. Tiene posibilidades de mejora, y puede adaptarse para un mejor funcionamiento dependiendo el tipo de usuario (productor o domestico). En línea general estoy conforme con el resultado del presente proyecto.

Todo el material será subido a un repositorio para facilitar su acceso.

https://github.com/zalotores/sistemaDeRiego.git

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

APENDICE 1 – MANUAL DE USUARIO

Este apéndice tiene el objetivo de incluir en un mismo documento el manual de uso del equipo, el cual estaría disponible en soporte físico o digital para el usuario final, indicando funcionalidades y mantenimiento. También tiene la función de generar un canal de post venta y contacto para futuros productos.

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

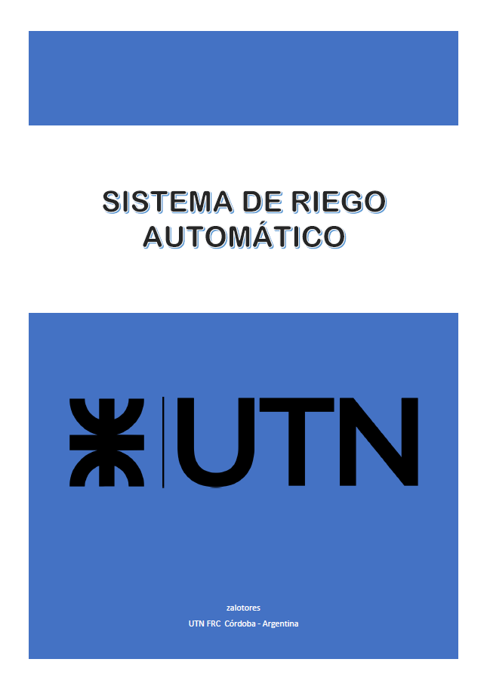
[picture p28: figure]

2020 - 2022 | Tecnicatura Superior en Mecatrónica

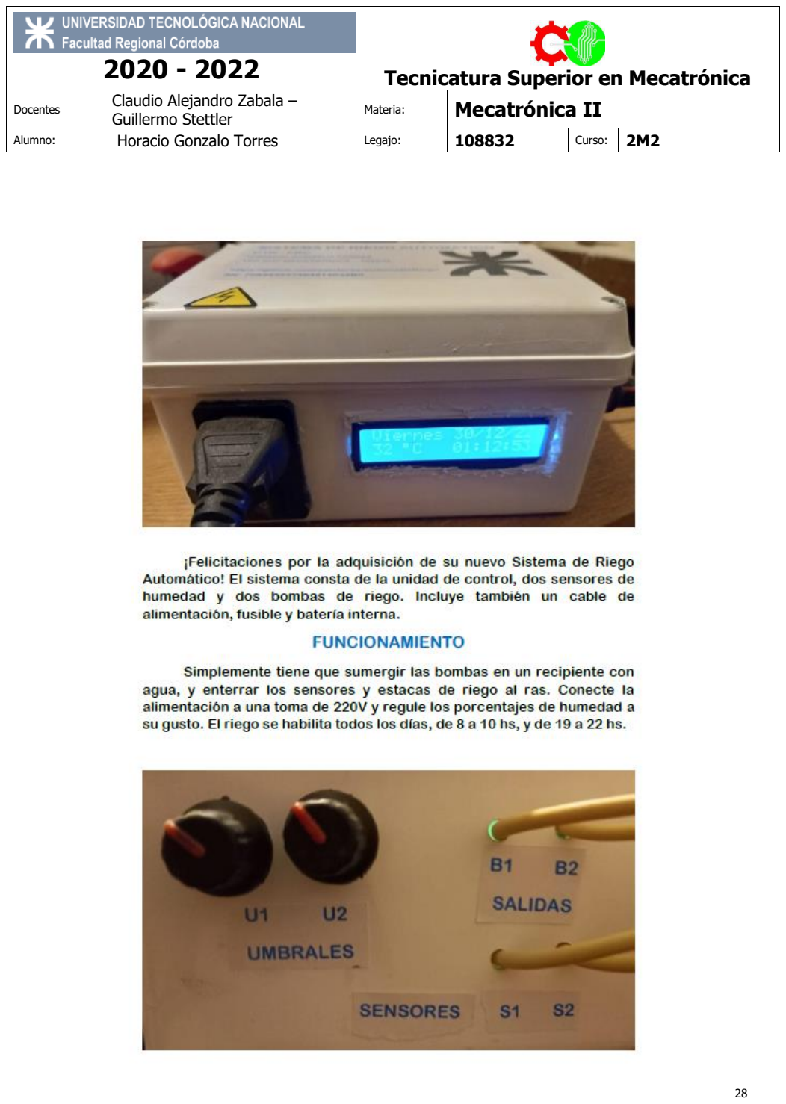
[picture p29: page 29]
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

2020 - 2022 | Tecnicatura Superior en Mecatrónica

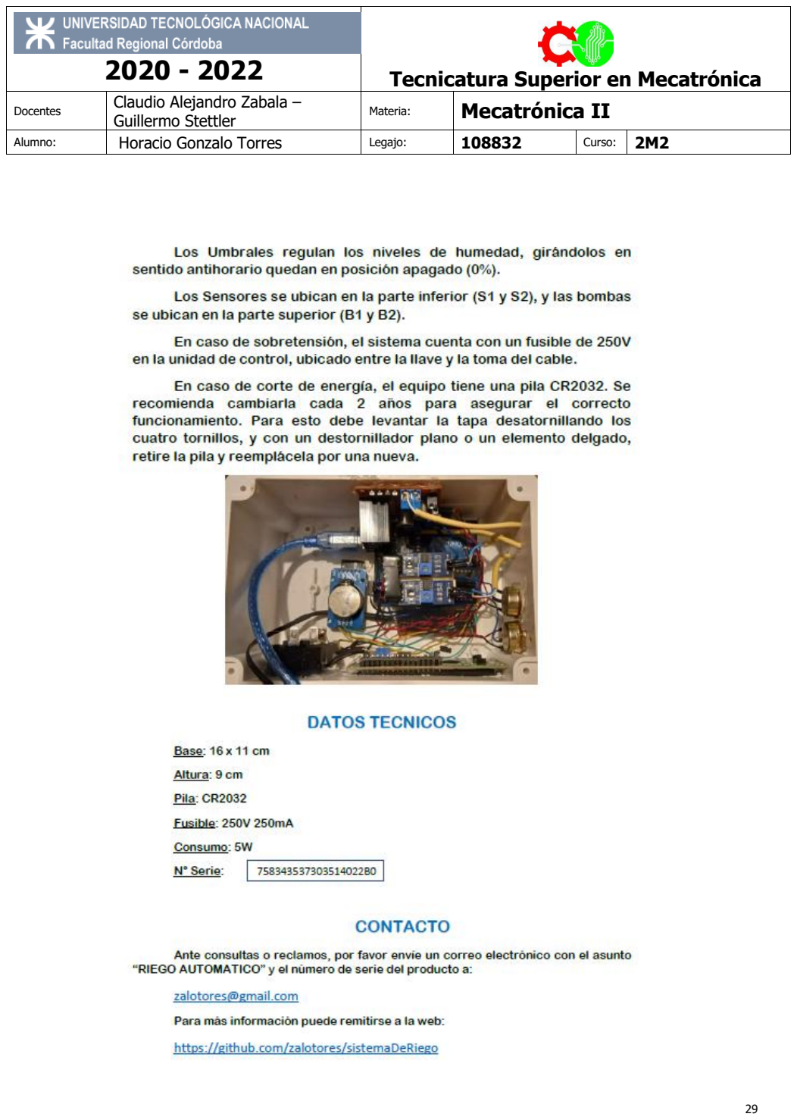
[picture p30: page 30]
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
